thehevy/2026_TiTG_Haunted_Theatre/components/uno/PINOUT.md

# Arduino UNO Pinout Guide

**Created:** 2026-08-07  
**Last Updated:** 2026-10-03

Target sketch:

- `components/uno/UNO_Node/UNO_Node.ino`

## Function Map

| Function | UNO Pin | Notes |
| --- | --- | --- |
| IR programming input | D2 | Used for IR programming and option selection. Code `0x00` triggers Relay 1 only. |
| Positive trigger input | D7 | Active HIGH. Keeps Relay 2 active only while D7 remains HIGH. |
| Negative trigger input | D8 | Active LOW. Keeps Relay 3 active only while D8 remains LOW. Use pull-up or internal pull-up. |
| Relay 1 output | D4 | Pulse output for the IR `0x00` trigger. |
| Relay 2 output | D5 | Held active while D7 stays HIGH. |
| Relay 3 output | D6 | Held active while D8 stays LOW. |

## Power and Ground

| Device | UNO Connection |
| --- | --- |
| Relay module VCC | External 5V recommended |
| Relay module GND | Common GND with UNO |
| Positive trigger source GND | Common GND with UNO |
| Negative trigger switch/sensor | Connect between D8 and GND |

## Board Power Input (Onboard Connector)

| Input Path | Connector Available | Minimum Input | Maximum Input | Notes |
| --- | --- | --- | --- | --- |
| USB power | Yes (USB-B on UNO R3 class boards)  | 4.75V | 5.25V | Preferred for bench setup and programming. |
| Barrel jack / VIN | Yes | 7V (recommended minimum) | 12V (recommended maximum) | Board family limit is wider, but 7V to 12V is the practical operating range. |

## Optional IR Receiver (KY-022 / TL1838 / VS1838B)

### Pinout

- KY-022 signal (S/OUT) -> UNO D2
- KY-022 GND (-) -> UNO GND
- KY-022 VCC (+) -> UNO 5V

### Required Components

- 1x Arduino UNO or Nano (ATmega328P)
- 1x 3-channel relay module (or three single-relay modules)
- 1x KY-022 (TL1838/VS1838B) IR receiver module
- 1x IR remote transmitter
- 1x 10k pull-down resistor for D7 so the positive trigger line stays LOW by default
- 1x 10k pull-up resistor for D8 if needed
- Jumper wires and a common ground

### IR Command Map

| Remote Button | IR Code | Action |
| --- | --- | --- |
| `0` | `0x00`  | Pulse D4 |

## Required Components and Resistor Guidance

- 1x Arduino UNO or Nano (ATmega328P)
- 1x 3-channel relay module (or three single-relay modules)
- 1x KY-022 (TL1838/VS1838B) IR receiver module
- 1x IR remote transmitter
- 1x 10k pull-down resistor for D7 so the line stays LOW by default
- 1x 10k pull-up resistor for D8 if the trigger source is open collector or floating
- Jumper wires, terminal blocks, and a stable common ground

### Wiring notes for safe signal conditioning

1. Connect the positive trigger source to D7 through a proper signal path, and add a 10k resistor from D7 to GND so the line stays LOW until a valid HIGH signal is present.
2. Do not tie D7 directly to 5V without a resistor path to ground; this can leave the line floating during reset and can stress the signal source.
3. For the negative trigger, wire D8 to a pull-up or use the internal pull-up, and switch the sensor to ground only when active.
4. Keep the relay coil supply and the Arduino ground common, but do not power the relay coil from the same pin supply without appropriate flyback protection.

## Relay Logic

- The sketch is configured for active LOW relays.
- If your relay board is active HIGH, set `RELAY_ACTIVE_LOW` to `false` in the sketch.
- For the current trigger model, D7 and D8 behave as held-state triggers rather than momentary pulses.

## Validation

1. Open the Serial Monitor at `115200`.
2. Press reset and confirm the startup banner.
3. Drive D7 HIGH and verify the sketch reports `POSITIVE -> Relay 2 active while D7 stays HIGH`.
4. Release D7 and verify Relay 2 turns off.
5. Pull D8 LOW and verify the sketch reports `NEGATIVE -> Relay 3 active while D8 stays LOW`.
6. Release D8 and verify Relay 3 turns off.
7. Transmit IR code `0x00` and verify Relay 1 pulses once.
8. Confirm the startup banner shows `Default timeout: none`.

## Serial Control

- Baud: `115200`
- Header and log text is printed on USB Serial (`Serial`), not on a GPIO pin.
- `1` pulses Relay 1, `2` holds Relay 2, and `3` holds Relay 3 for test use.
- `i` prints the last IR command and raw code.
