thehevy/2026_TiTG_Haunted_Theatre/(commit log)

2026-08-06 Initial commit: Arduino 101 node firmware, central controller scaffold, and setup docs
2026-08-14 Add IR decode support and update component wiring docs
2026-08-14 Add Acebott ESP32-Max node sketch with WiFi/MQTT and UNO IR mapping
2026-10-03 Align board docs and trigger logic
2026-10-13 Fix ESP32 smart skull Servo library and document pinout
2026-10-19 Add simple IR trigger sketches with status LEDs and pinout guides
    - Add simple IR trigger sketches, each in its own folder with a PINOUT.md:
    - Arduino 101: negative trigger (5 V active-LOW relay, D4 high-Z when idle),
    plus 15 s and 60 s pulse variants
    - UNO: negative trigger (5 V active-LOW relay)
    - ESP-12F and WeMos D1 R32: positive trigger (3.3 V active-HIGH relay)
    - Add IR-activity and relay status LEDs to all simple sketches, with a
    status LED troubleshooting table in each pinout guide
    - Arduino 101 reads the IR receiver directly (IRremote has no Curie support)
    - Move HauntedHouseRF.ino into its own sketch folder
    - ESP-01 pinout: GPIO0 boot-strap guidance and transistor drive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
2026-10-19 Add ESP32-S3 smart tracking skull variant
    - Add ESP32S3_SmartTracking_Node sketch for the ESP32-S3-WROOM-1
    (two VL53L1X ToF sensors, skull servo, DFPlayer Mini, eye LEDs)
    - Add ESP32S3_SMART_TRACKING_PINOUT.md for the S3 pin map
    - ESP32 PINOUT.md: note I2C SCL is GPIO20 on ESP32-S3 (not GPIO22) and
    link both smart tracking skull variants
    - SMART_TRACKING_PINOUT.md: point to the separate S3 pinout
2026-10-20 Add arduino-cli compile/upload tooling and fix ESP8266_Node build
    - tools/arduino/arduino.ps1: setup, list, ports, compile, upload, monitor
    - tools/arduino/sketches.json: sketch-to-FQBN map, cores, libraries
    - .vscode/tasks.json: VS Code tasks for compile/upload/monitor
    - Remove orphaned block after loop() in ESP8266_Node.ino
    - Document CLI workflow in SETUP_GUIDE.md and README.md
2026-10-20 Configure VS Code C/C++ IntelliSense for Arduino sketches
    - arduino.ps1 intellisense: build .build/compile_commands.json from arduino-cli,
    expanding @response files and -iprefix includes, force-including Arduino.h
    - Add .vscode/c_cpp_properties.json and settings.json (*.ino as C++)
    - Add Refresh IntelliSense task; gitignore .build/
    - Document in SETUP_GUIDE.md, README.md, SESSION_NOTES.md
2026-10-20 Document Arduino 101 Windows 11 DFU driver fix and first upload
    - SETUP_GUIDE.md: Zadig WinUSB fix for VID 8087 PID 0ABA when Intel
    dpinst drivers are rejected on Windows 11
    - SESSION_NOTES.md: first successful upload on COM6, updated next steps
2026-10-20 Add Arduino101_TimedTriggerRelay sketch with selectable 1-60 s pulse
    - Positive (D7) or negative (D8) trigger pulses active-LOW relay on D4
    - A0-A4 duration selector: 1/5/15/30/60 s; edge-triggered with lockout
    - PINOUT.md with wiring, trigger logic, troubleshooting, validation
    - Register in sketches.json and VS Code task picker
    - Fix arduino.ps1 partial IntelliSense refresh dropping entries (PS 5.1)
2026-10-20 Add RF code 0x0 trigger on D3 and fix Arduino101_Node dead 0x0 check
    - Arduino101_SimpleIRNegativeTriggerCode0x0: 433 MHz RF on D3 via polling
    decoder using rc-switch protocol rules (D3 has no CHANGE interrupt on
    Curie); prints every code, triggers D4 only on 0x0; noise filtering
    - Arduino101_Node: remove unreachable received == 0x0 branch (rc-switch
    never reports 0); correct header text and arduino101 PINOUT.md
    - Register sketch; update SESSION_NOTES
2026-10-20 Add Arduino101_LaserTagIRNegativeTrigger (gun-only IR trigger)
    - Replace RF code 0x0 attempt with polled IR decoder on D3 for the
    Sharper Image laser tag gun: 6 ms leader + 9 pulse-width bits, 5 frames
    per shot; any team/mode triggers (GUN_CODE_MASK to restrict)
    - Phones (Face ID IR), TV remotes and noise are reported and ignored;
    NEC codes printed for reference
    - Bench-verified on COM7: 10/10 shots triggered, iPhone IR ignored
    - Rename sketch folder from Arduino101_SimpleIRNegativeTriggerCode0x0
    - arduino.ps1 intellisense drops entries for deleted sketch files
    - Update PINOUT, README, SESSION_NOTES, arduino101 PINOUT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
2026-10-20 Add Arduino101_LaserTagIRNegativeTrigger5s (5 s relay pulse)
    Same laser tag IR decoder and wiring; TRIGGER_PULSE_MS = 5000.
2026-10-20 Add Arduino101_LaserTagIRNegativeTrigger60s (60 s relay pulse)
    Same laser tag IR decoder and wiring; TRIGGER_PULSE_MS = 60000.
2026-10-20 Session notes: COM8 board running laser tag 60 s sketch
2026-10-20 Session notes: COM9 board running laser tag 5 s sketch
2026-10-20 Session notes: COM10 board, board inventory table
2026-10-21 Session notes: COM12 board running laser tag 500 ms sketch
2026-10-21 Add Arduino101_LaserTagIRNegativeTrigger10s (10 s relay pulse)
    Same laser tag IR decoder and wiring; TRIGGER_PULSE_MS = 10000.
2026-10-21 Session notes: COM13 board running laser tag 10 s sketch
2026-10-21 Add UNO_LaserTagIRNegativeTrigger (UNO R3 port, 500 ms)
    Same polled laser tag decoder as the Arduino 101 sketch; UNO wiring
    matches UNO_SimpleIRNegativeTrigger (IR D2, relay D8, LEDs D5/D6).
    Relay driven directly at 5 V, set HIGH before output to avoid boot blip.
2026-10-21 Session notes: COM14 UNO clone running UNO laser tag sketch
2026-10-21 Add Nano_LaserTagIRNegativeTrigger (Arduino Nano port, 500 ms)
    Same laser tag decoder as the UNO port. Pins follow Nano_Node: IR D2,
    relay D4; D5/D6 untouched; onboard D13 LED shows relay status.
    FQBN arduino:avr:nano:cpu=atmega328old.
2026-10-21 Nano laser tag: default to new bootloader; COM15 Nano verified
    - sketches.json: Nano_LaserTagIRNegativeTrigger fqbn -> cpu=atmega328
    (bench CH340 Nano has the new bootloader)
    - arduino.ps1: Nano upload hint (bootloader -Fqbn, replug on hang);
    drop auto bootloader fallback (old-bootloader attempt can hang avrdude)
    - Docs: PINOUT board setup, README, SESSION_NOTES inventory and gotchas
2026-10-21 Session notes: COM16 Arduino 101 running laser tag 5 s sketch
2026-10-21 Session notes: second Nano laser tag upload on COM15
2026-10-21 Session notes: COM13 reflashed to laser tag 500 ms
2026-10-21 Session notes: COM17 Arduino 101 running laser tag 500 ms
2026-10-22 Session notes: COM18 Arduino 101 laser tag 500 ms upload
2026-10-22 Session notes: COM19 Arduino 101 running laser tag 500 ms
2026-10-22 Add Arduino101_LaserTagIRDualTrigger (D4 negative + D5 positive)
    500 ms laser tag sketch with an added active-HIGH output on D5 that
    fires together with the D4 active-LOW output; IR LED moved D5 -> D7.
2026-10-22 Session notes: WeMos fails on COM20 too (board/cable, not socket)
2026-10-22 Add UNO_LaserTagIRDualTrigger; COM22 Arduino 101 runs dual trigger
    - UNO dual trigger: negative D8 + positive D5 (5 V), IR LED D5 -> D7
    - COM22 Arduino 101 verified running Arduino101_LaserTagIRDualTrigger
    - COM21 Elegoo UNO bootloader not responding (recorded in notes)
2026-10-22 Session notes: COM23 Arduino 101 running dual trigger
2026-10-23 Add Arduino 101 PIR/laser sound trigger sketches (DFPlayer and CH9311)
    - Arduino101_PIRLaserSoundTrigger: 3 PIR + 1 laser sensor play their own
    DFPlayer Mini track (Serial1 on D0/D1, BUSY on D10); each sensor's
    negative trigger output (D6-D9) stays LOW while its sound plays
    - Arduino101_PIRLaserCH9311Trigger: same trigger logic for the CH9311-FL,
    driven by low-level key presses on K1-K4 (D10, D11, D12, A0), with
    per-sensor sound durations and an optional Busy LED tap
    - Both: one sound at a time (other triggers ignored), 15 s per-sensor
    cooldown, 10 s sensor warm-up, outputs high-Z when idle for 5 V
    active-LOW relays
    - Register both sketches in tools/arduino/sketches.json and task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
2026-10-23 Add Nano_LaserTagIRNegativeTrigger5s (5 s relay pulse)
    User copy of the Nano laser tag sketch with TRIGGER_PULSE_MS = 5000;
    register it, update PINOUT timings, uploaded to COM15.
2026-10-23 Nano 5 s laser tag: (5 s) banner/comment; align PINOUT
2026-10-26 Consolidate non-WiFi IR triggers into *_LaserTagIRTrigger; archive old sketches
    - New Arduino101_/UNO_/Nano_LaserTagIRTrigger (one shared source): any valid IR
    code (laser tag, Sony, NEC/Samsung/Panasonic, LED remotes) fires D4 LOW + D5 HIGH;
    phones/sunlight ignored. D8/D9 duration jumpers (0.5/5/10/15 s, live), no retrigger
    during a pulse plus re-arm gap, optional D2 wired input (off by default), D10 -> D11 aux.
    - EEPROM settings + serial commands, and a Web Serial config page (tools/web-config).
    - Optional DFPlayer Mini: IR cycles folder 01 (resets after idle), D2 -> 02/001, D10 -> 02/002.
    - Archived earlier laser tag, simple IR, node (101/UNO/Nano), RF, timed relay, CH9311,
    and We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
2026-10-26 Add WiFi builds of the unified laser tag IR trigger; archive old WiFi nodes
    - One shared .ino for all six *_LaserTagIRTrigger sketches (Arduino 101, UNO, Nano,
    ESP32/Acebott ESP32-Max, ESP8266, ESP-01); per-folder board_config.h holds pins and
    features. arduino.ps1 sync copies the Arduino 101 copy to the other folders.
    - WiFi builds: join the router or run a WPA2 setup AP (no SSID, router unreachable,
    BOOT/FLASH 3 s, 3 quick resets, serial AP); settings page with admin login, form
    token, and hidden passwords; MQTT status/trigger/event/heartbeat with broker login;
    OTA from the page or arduino.ps1 upload -Port <ip>. Interrupt-driven IR on ESP.
    - ESP-01: GPIO2 is the IR receiver or a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
2026-10-26 ESP-01: match the old ESP01_Node wiring and timing out of the box
    - New board_config options: MAIN_OUTPUT_ACTIVE_HIGH and per-board DEFAULT_WIRED_INPUT,
    DEFAULT_MAIN_MS, DEFAULT_REARM_MS (other boards keep their previous defaults).
    - ESP-01 build: GPIO0 goes HIGH for 1 s (NPN relay driver, 10k pull-up), IR sensor on
    GPIO2 fires on HIGH, 15 s cooldown (1 s pulse + 14 s re-arm). GPIO0 is driven LOW
    first thing in setup to keep the boot-time relay blip short.
    - Updated ESP-01 pinout, transition guide Card G, README checklist, archive notes,
    and session notes.
2026-10-26 Firmware hardening: IR stuck-line abort, generated WiFi passwords, timer-ended pulses
    - Drop IR captures when the line is LOW > 15 ms or busy > 400 ms; log + heartbeat fault count
    - WiFi: no default SSID/passwords; random AP/admin passwords printed on serial until changed (config v5)
    - Pulses end on a Ticker and outputs are time-based; unauthorized uploads disconnected
    - ESP8266/ESP-01 reset counter in RTC memory (RST presses only, no flash writes)
    - applyOutputs first in setup; CSRF token after WiFi start
    - Docs: ESP-01 GPIO0 power-up check, new first-setup steps, compile baselines
2026-10-26 Controller auth/validation, MQTT event+heartbeat, safer deploy scripts; sync -Check and CI
    - Basic-auth login (ADMIN_PASSWORD in .env, generated by the installer); /api/health stays open
    - Validate device_id (firmware rule) and allow only main/aux; JSON-only trigger POST; security headers
    - lifespan startup, background MQTT connect with reconnect; subscribe to event and heartbeat
    - Uvicorn on 127.0.0.1; bootstrap scripts prompt for passwords and never print them; reinstall keeps .env
    - pytest suite (18 tests); arduino.ps1 sync -Check; GitHub Actions build; .gitattributes text=auto
2026-10-26 Firmware: DFPlayer reply checks, best-frame IR count, stable device_id until reboot
    - Verify DFPlayer reply checksums; only file-missing errors end the folder 01 sequence
    - Pulse-width decode counts the most frequent frame code for pw_min_frames
    - WiFi boards keep the boot-time device_id for hostname, AP, MQTT, OTA; serial SET of network keys says to reboot
    - Docs: measure 5 V relay IN on ESP boards; compile baselines
2026-10-26 Optional controller HTTPS script, MIT license, README dev steps
    - deploy/nginx-tls.sh: self-signed cert, HTTPS site with HTTP redirect, fingerprint output
    - LICENSE (MIT)
    - README dev mode: ADMIN_PASSWORD, SQLite option, tests; SETUP_GUIDE date
